lias-bischof/robotic-arm/CAD/Assets/10-1-Übersetzung.step

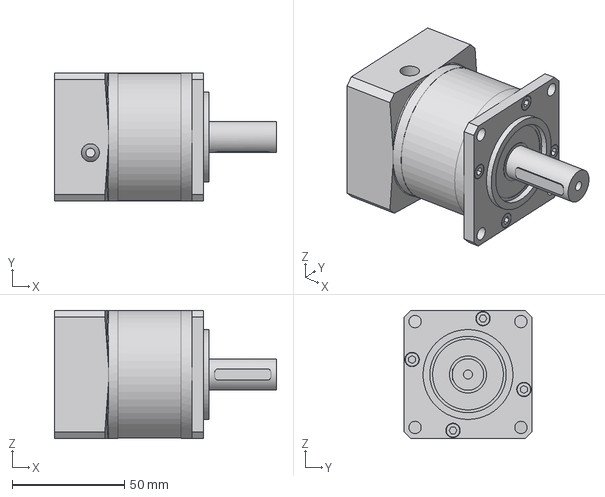
[picture p18: CAD file, 2026-10-17]
CAD/Assets/10-1-Übersetzung.step
98.8 x 57.0 x 57.0 mm
