lias-bischof/robotic-arm/CAD/Drucke:STEP/Schulter Aufhängung Außen 02 FERTIG.step

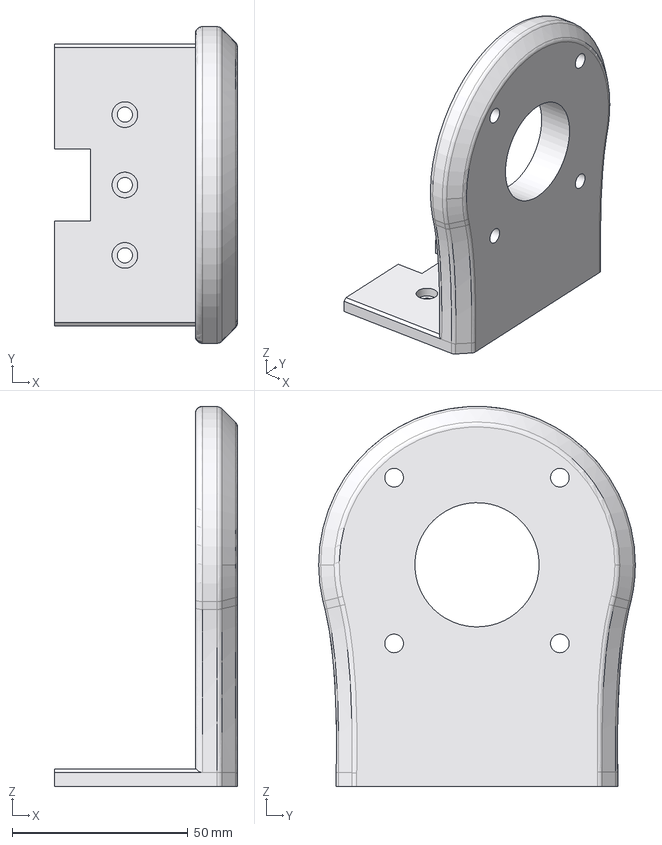
[picture p19: CAD file, 2026-10-17]
CAD/Drucke:STEP/Schulter Aufhängung Außen 02 FERTIG.step
52.0 x 90.0 x 108.0 mm
