lias-bischof/robotic-arm/CAD/Assets/nema23_57byg201.step

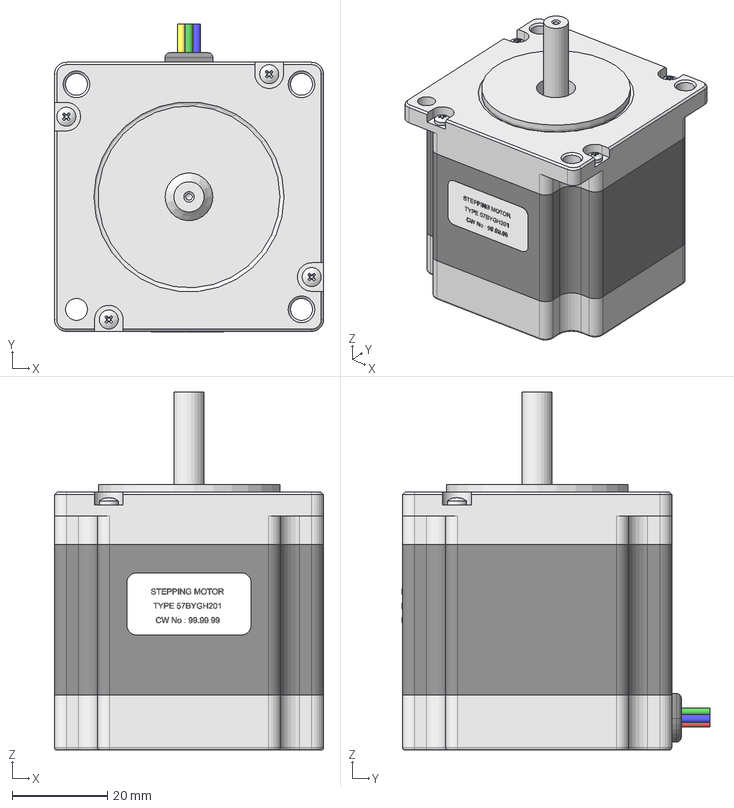
[picture p20: CAD file, 2026-10-17]
CAD/Assets/nema23_57byg201.step
56.4 x 64.5 x 75.0 mm
Up
Axe
Bottom
Middle
M2x50-Screw x 4
Sticker
Rubber
RedWire
GreenWire
BlueWire
YellowWire
