lias-bischof/robotic-arm/CAD/Drucke:STEP/Fuß Achse FERTIG.step

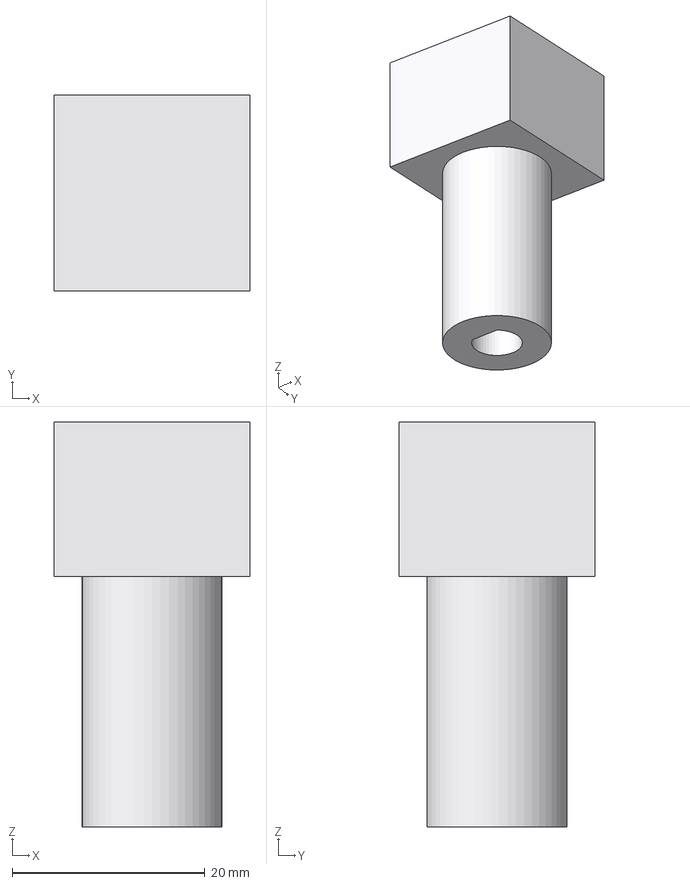
[picture p21: CAD file, 2026-10-17]
CAD/Drucke:STEP/Fuß Achse FERTIG.step
20.3 x 20.3 x 42.0 mm
