lias-bischof/robotic-arm/CAD/Drucke:STEP/Riemen Output 01.step

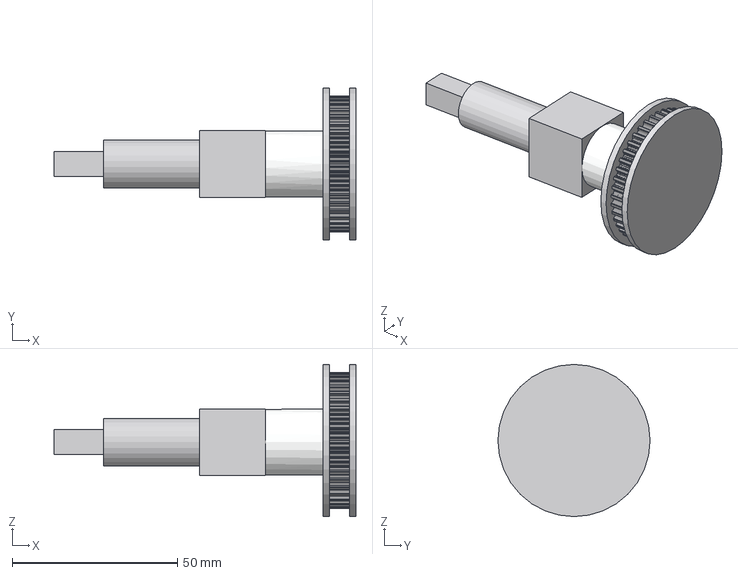
[picture p22: CAD file, 2026-10-17]
CAD/Drucke:STEP/Riemen Output 01.step
91.3 x 46.0 x 46.0 mm
