lias-bischof/robotic-arm/CAD/Drucke:STEP/Fuß Gehäuse Oben FERTIG.step

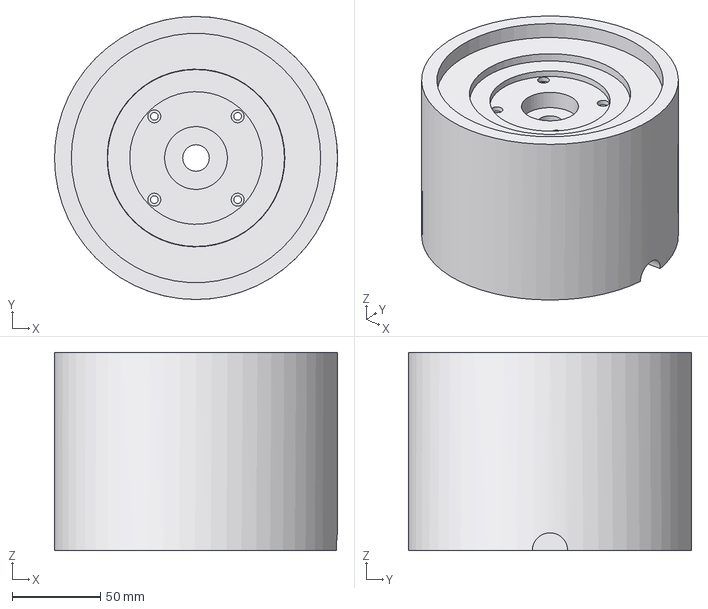
[picture p23: CAD file, 2026-10-17]
CAD/Drucke:STEP/Fuß Gehäuse Oben FERTIG.step
160.0 x 160.0 x 112.0 mm
