lias-bischof/robotic-arm/CAD/Drucke:STEP/Schulter Achse 02.step

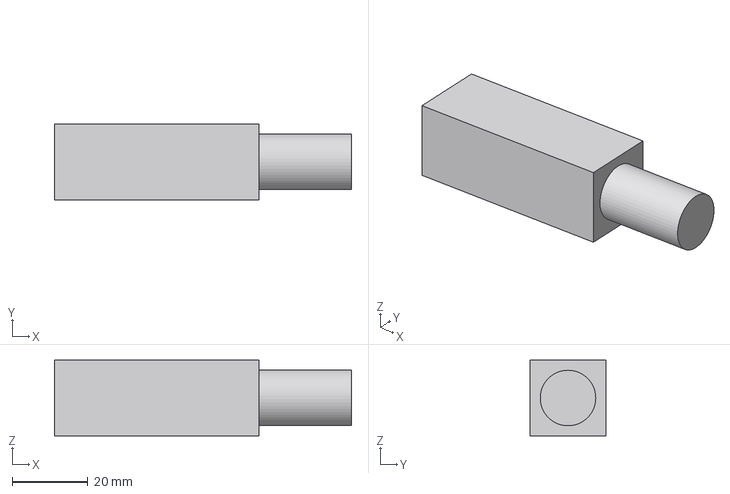
[picture p24: CAD file, 2026-10-17]
CAD/Drucke:STEP/Schulter Achse 02.step
78.6 x 20.0 x 20.0 mm
