lias-bischof/robotic-arm/CAD/Drucke:STEP/Schulter Aufhängung Innen 02.step

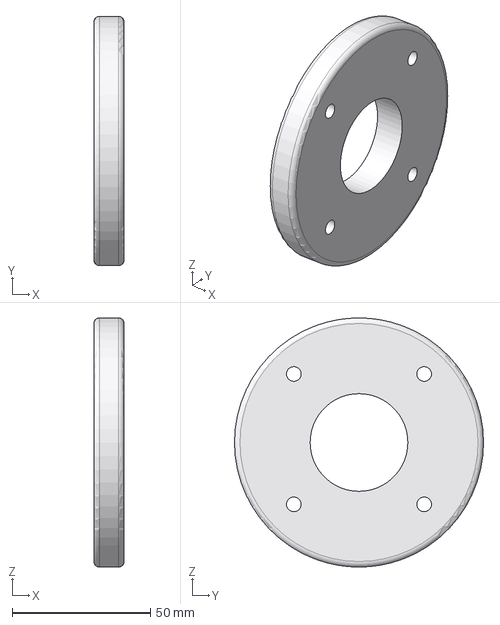
[picture p25: CAD file, 2026-10-17]
CAD/Drucke:STEP/Schulter Aufhängung Innen 02.step
11.0 x 90.0 x 90.0 mm
