lias-bischof/robotic-arm/CAD/Drucke:STEP/Schulter Achse 01.step

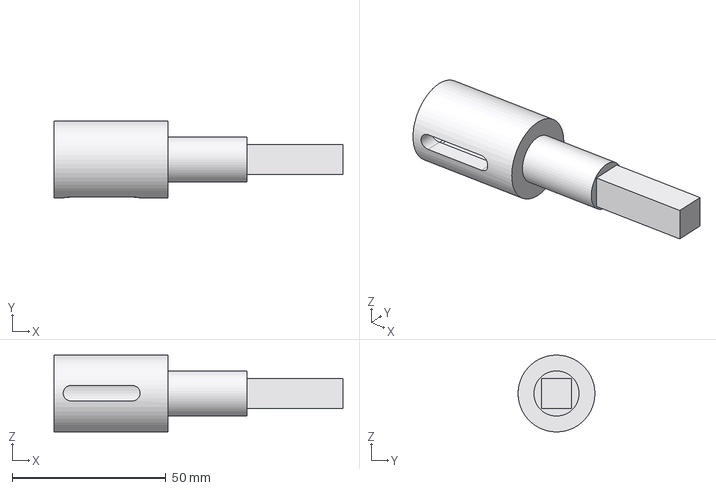
[picture p26: CAD file, 2026-10-17]
CAD/Drucke:STEP/Schulter Achse 01.step
94.0 x 25.0 x 25.0 mm
