lias-bischof/robotic-arm/CAD/Drucke:STEP/Riemen Input.step

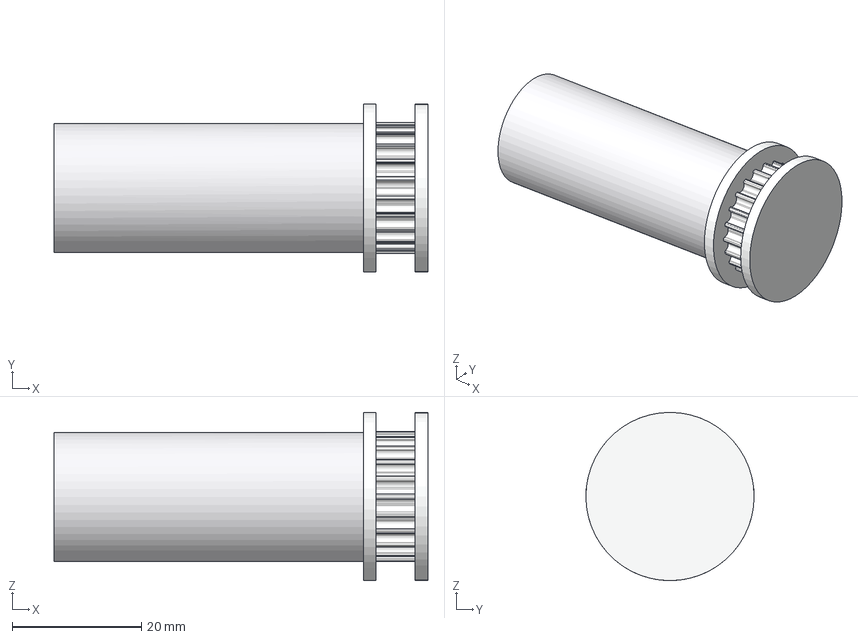
[picture p27: CAD file, 2026-10-17]
CAD/Drucke:STEP/Riemen Input.step
57.8 x 26.0 x 26.0 mm
