lias-bischof/robotic-arm/CAD/Drucke:STEP/Kalibiergehäuse.step

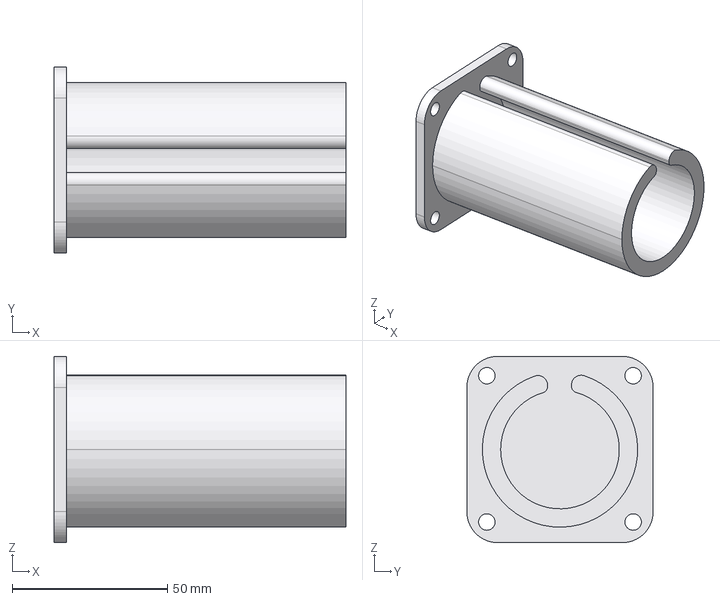
[picture p28: CAD file, 2026-10-17]
CAD/Drucke:STEP/Kalibiergehäuse.step
94.0 x 60.0 x 60.0 mm
