lias-bischof/robotic-arm/CAD/Drucke:STEP/Übersetzung Achse Verbindung.step

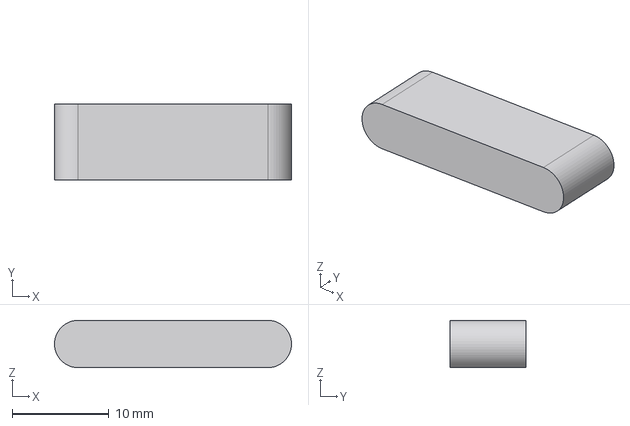
[picture p29: CAD file, 2026-10-17]
CAD/Drucke:STEP/Übersetzung Achse Verbindung.step
24.5 x 7.84 x 4.90 mm
