lias-bischof/robotic-arm/CAD/Drucke:STEP/Schulter 02 FERTIG.step

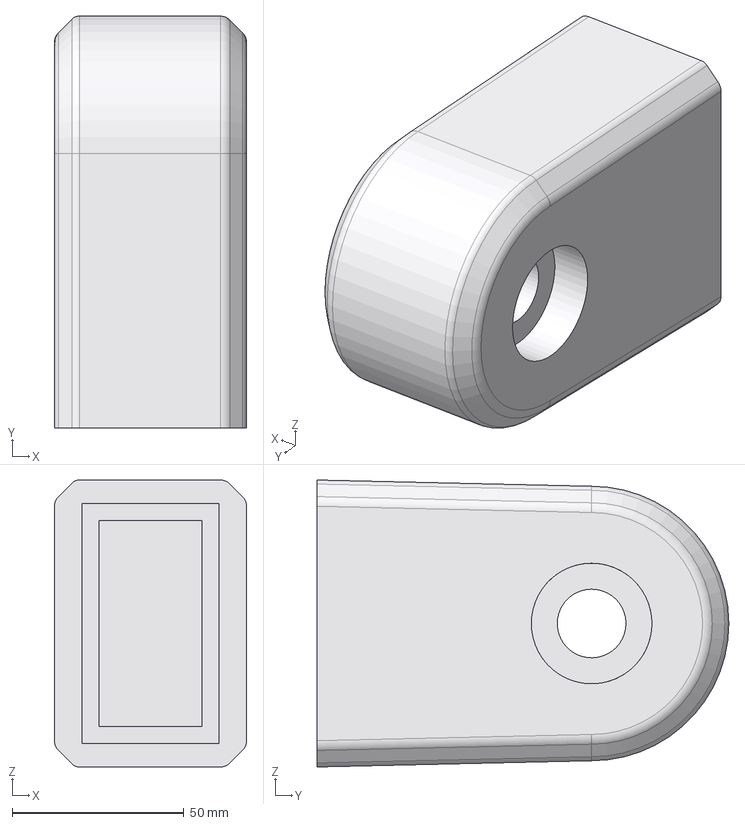
[picture p30: CAD file, 2026-10-17]
CAD/Drucke:STEP/Schulter 02 FERTIG.step
56.0 x 120.0 x 83.6 mm
