lias-bischof/robotic-arm/CAD/Drucke:STEP/Schulter.step

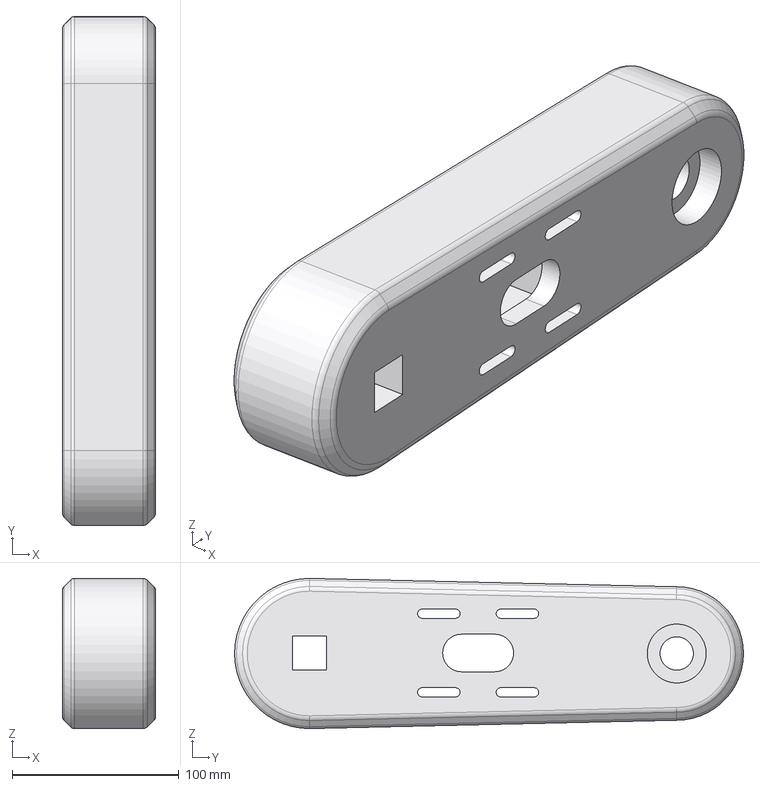
[picture p31: CAD file, 2026-10-17]
CAD/Drucke:STEP/Schulter.step
56.0 x 305.0 x 90.0 mm
