lias-bischof/robotic-arm/CAD/Drucke:STEP/Schulter 01 FERTIG.step

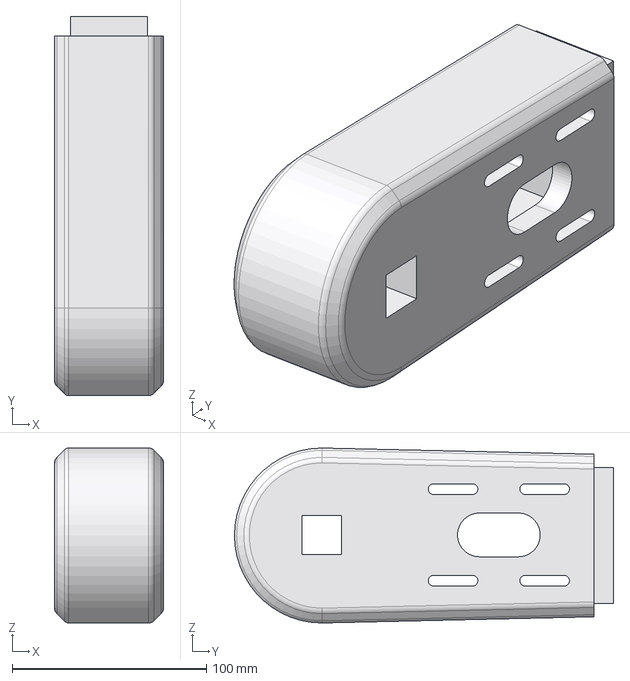
[picture p32: CAD file, 2026-10-17]
CAD/Drucke:STEP/Schulter 01 FERTIG.step
56.0 x 195.0 x 90.0 mm
