lias-bischof/robotic-arm/CAD/Drucke:STEP/Drehteller FERTIG.step

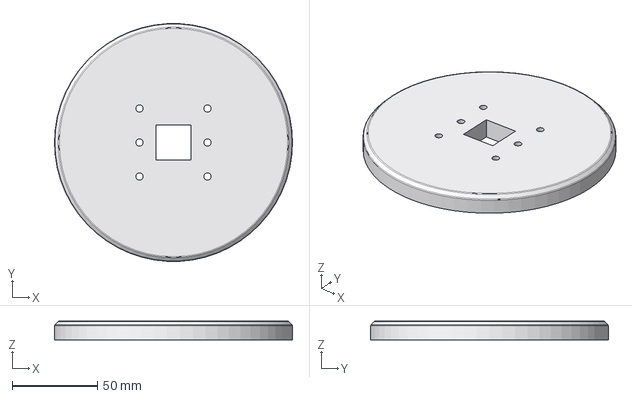
[picture p33: CAD file, 2026-10-17]
CAD/Drucke:STEP/Drehteller FERTIG.step
140.0 x 139.8 x 11.0 mm
