lias-bischof/robotic-arm/CAD/Drucke:STEP/Arm.step

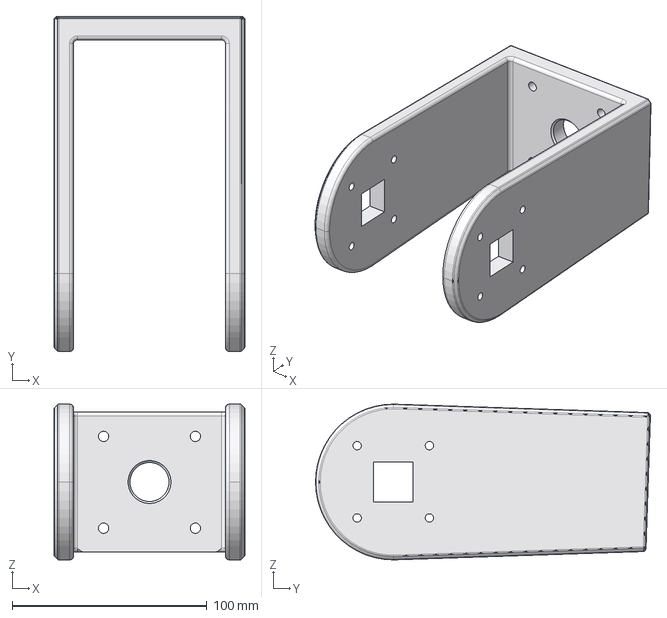
[picture p34: CAD file, 2026-10-17]
CAD/Drucke:STEP/Arm.step
98.0 x 172.0 x 80.0 mm
