lias-bischof/robotic-arm/CAD/Drucke:STEP/Arm Aufhängung 2.step

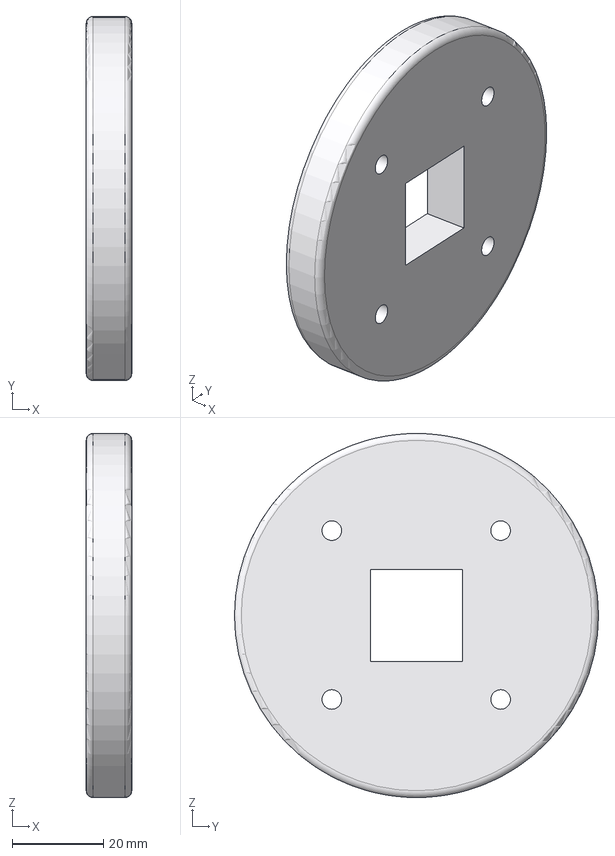
[picture p35: CAD file, 2026-10-17]
CAD/Drucke:STEP/Arm Aufhängung 2.step
10.0 x 80.0 x 80.0 mm
