lias-bischof/robotic-arm/CAD/Drucke:STEP/Schulter Brücke FERTIG.step

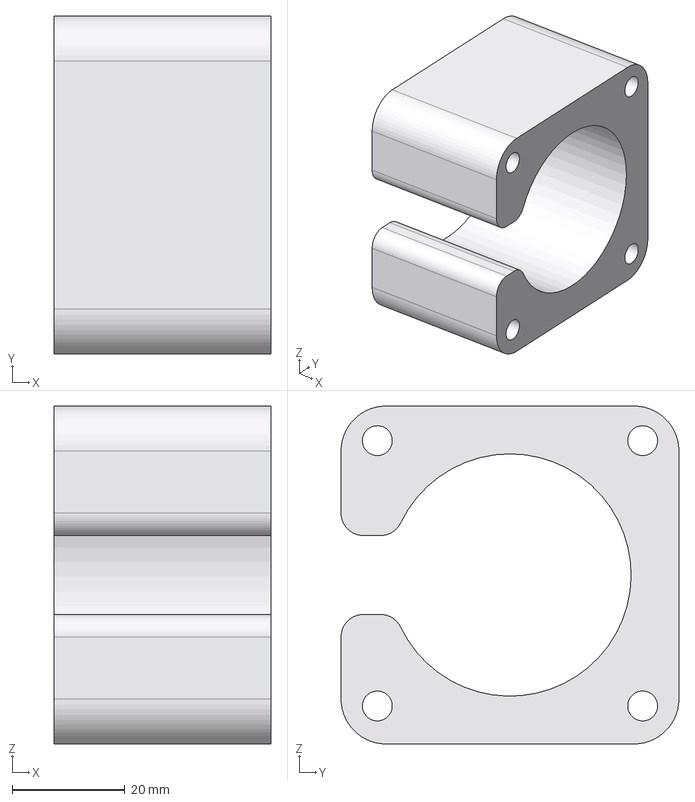
[picture p36: CAD file, 2026-10-17]
CAD/Drucke:STEP/Schulter Brücke FERTIG.step
38.5 x 60.0 x 60.0 mm
