lias-bischof/robotic-arm/CAD/Drucke:STEP/Riemen Output 02.step

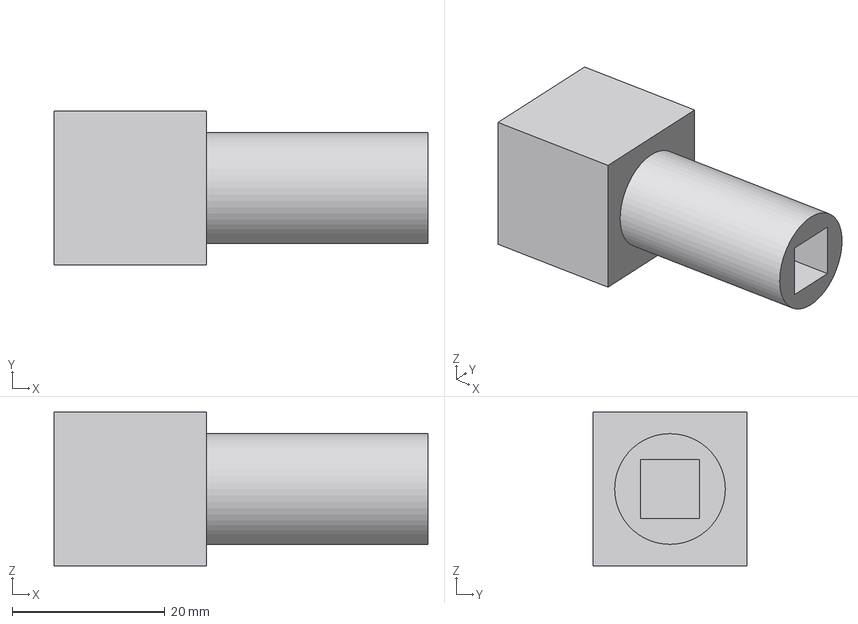
[picture p37: CAD file, 2026-10-17]
CAD/Drucke:STEP/Riemen Output 02.step
49.0 x 20.2 x 20.2 mm
