lias-bischof/robotic-arm/CAD/Drucke:STEP/Fuß Gehäuse Unten FERTIG.step

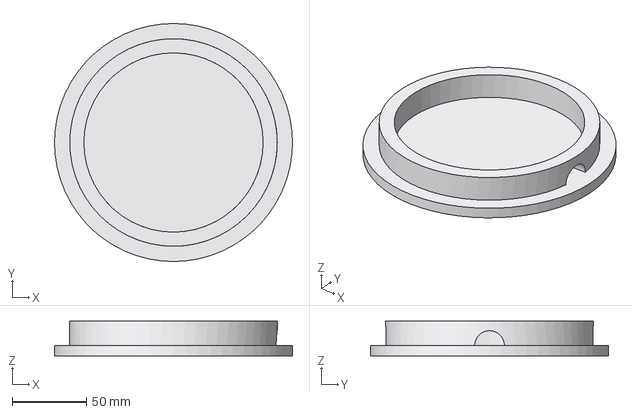
[picture p38: CAD file, 2026-10-17]
CAD/Drucke:STEP/Fuß Gehäuse Unten FERTIG.step
160.0 x 160.0 x 23.5 mm
