lias-bischof/robotic-arm/(list of files, cad)

Other CAD files:
CAD/Drucke:STEP/Schulter Aufhängung Innen 01.step
CAD/Drucke:STEP/Schulter Aufhängung Außen 01 FERTIG.step
CAD/Drucke:STEP/Arm Aufhängung 1.step
