lias-bischof/robotic-arm/(commit log)

2026-10-19 Enhance README with implementation and setup details
    Expanded the README with detailed implementation information, including electronics, control stack, motor channels, power interface, angle conversion, USB communication, and limitations. Added sections on repository structure, setup requirements, and learnings from the project.
2026-10-26 Fix stop behavior, gripper execution, timeouts, and backend build setup
